kapipara/kachisys/board/forMake/kachisys_parts.pdf

Part | Value | Device | Description
C1 | 22μF | C-EUC2012 | Capacitor
C2 | 22μF | C-EUC2012 | Capacitor
C3 | UWT1E221MNL1GS | ﾆﾁｺﾝ 電解ｺﾝ 8mm | Capacitor
C4 | 0.1μF | C-EUC0603 | Capacitor
C5 | 0.1μF | C-EUC0603 | Capacitor
C6 | 100μF | C-EUC3225 | Capacitor
C7 | 1000pF | C-EUC0603 | Capacitor
C8 | 1000pF | C-EUC0603 | Capacitor
C9 | 47pF | C-EUC1608 | Capacitor
C10 | 1000pF | C-EUC0603 | Capacitor
C11 | 47pF | C-EUC1608 | Capacitor
C12 | 0.1μF | C-EUC0603 | Capacitor
C13 | 0.1μF | C-EUC0603 | Capacitor
C14 | 1000pF | C-EUC0603 | Capacitor
C15 | 1000pF | C-EUC0603 | Capacitor
C16 | 0.1μF | C-EUC0603 | Capacitor
C17 | 0.1μF | C-EUC0603 | Capacitor
C18 | 0.1μF | C-EUC0603 | Capacitor
C19 | 0.1μF | C-EUC0603 | Capacitor
C20 | 0.1μF | C-EUC0603 | Capacitor
C21 | 0.1μF | C-EUC0603 | Capacitor
IC1 | LT1963ES8-3.3 | LT1963ES8-3.3 | 3V3 Regulator
J1 | S3B-PH-SM4-TB(LF)(SN) | S3B-PH-SM4-TB(LF)(SN) | PHコネクタ 3端子
J2 | S3B-PH-SM4-TB(LF)(SN) | S3B-PH-SM4-TB(LF)(SN) | PHコネクタ 3端子
J3 | S3B-PH-SM4-TB(LF)(SN) | S3B-PH-SM4-TB(LF)(SN) | PHコネクタ 3端子
J4 | S3B-PH-SM4-TB(LF)(SN) | S3B-PH-SM4-TB(LF)(SN) | PHコネクタ 3端子
J5 | S3B-PH-SM4-TB(LF)(SN) | S3B-PH-SM4-TB(LF)(SN) | PHコネクタ 3端子
J6 | S3B-PH-SM4-TB(LF)(SN) | S3B-PH-SM4-TB(LF)(SN) | PHコネクタ 3端子
J7 | S3B-PH-SM4-TB(LF)(SN) | S3B-PH-SM4-TB(LF)(SN) | PHコネクタ 3端子
J8 | ZX62R-AB-5P | ZX62R-AB-5P | Micro USB
J9 | 2DC-0415D200 | 2DC-0415D200 | DC Jack
LED1 | WS2812B_5050N | WS2812B_5050N | RGB LED
LED2 | WS2812B_5050N | WS2812B_5050N | RGB LED
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
TPAD5 | ESP32-TOUCHPAD | ESP32-TOUCHPAD | 表面タッチパッド
TPAD6 | ESP32-TOUCHPAD | ESP32-TOUCHPAD | 表面タッチパッド
TX | LED | LEDCHIP-LED0603 | chip LED
RX | LED | LEDCHIP-LED0603 | chip LED
U1 | FT231XS | FT231XS | USB⇔UART変換チップ
U2 | ESP-WROOM-32 | ESP-WROOM-32 | ESP32
U3 | BME280 | BME280 | 温湿度センサ
