kapipara/kachisys/kachisys.old/kachisys_body.stl

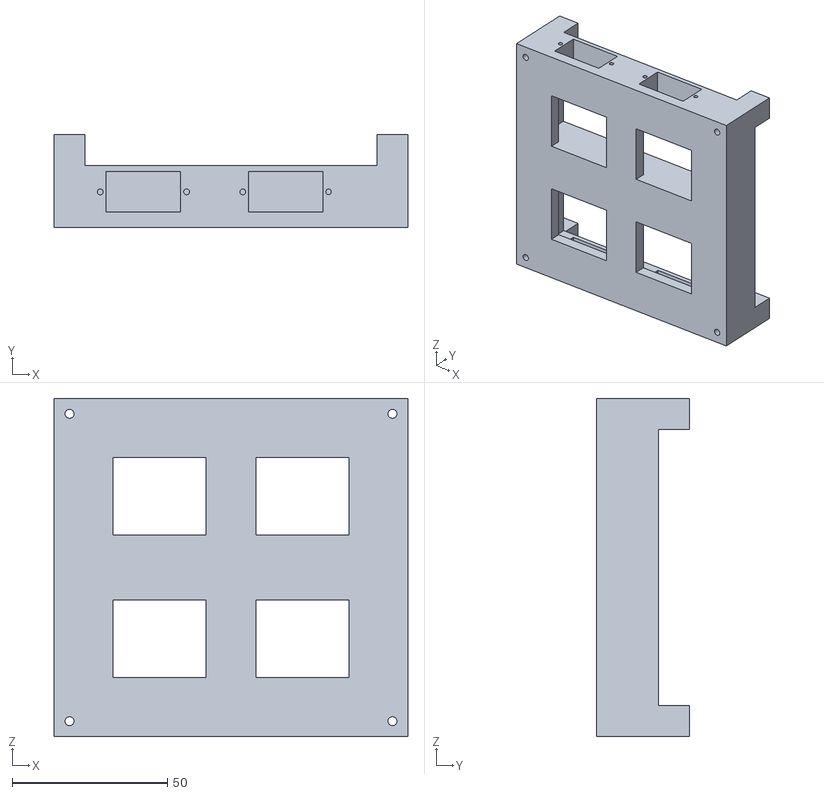
[picture p1: CAD file, 2018-10-15, an earlier design]
kachisys.old/kachisys_body.stl
114.0 x 30.0 x 109.0
