kapipara/kachisys/board/forMake/kachisys_sch.pdf

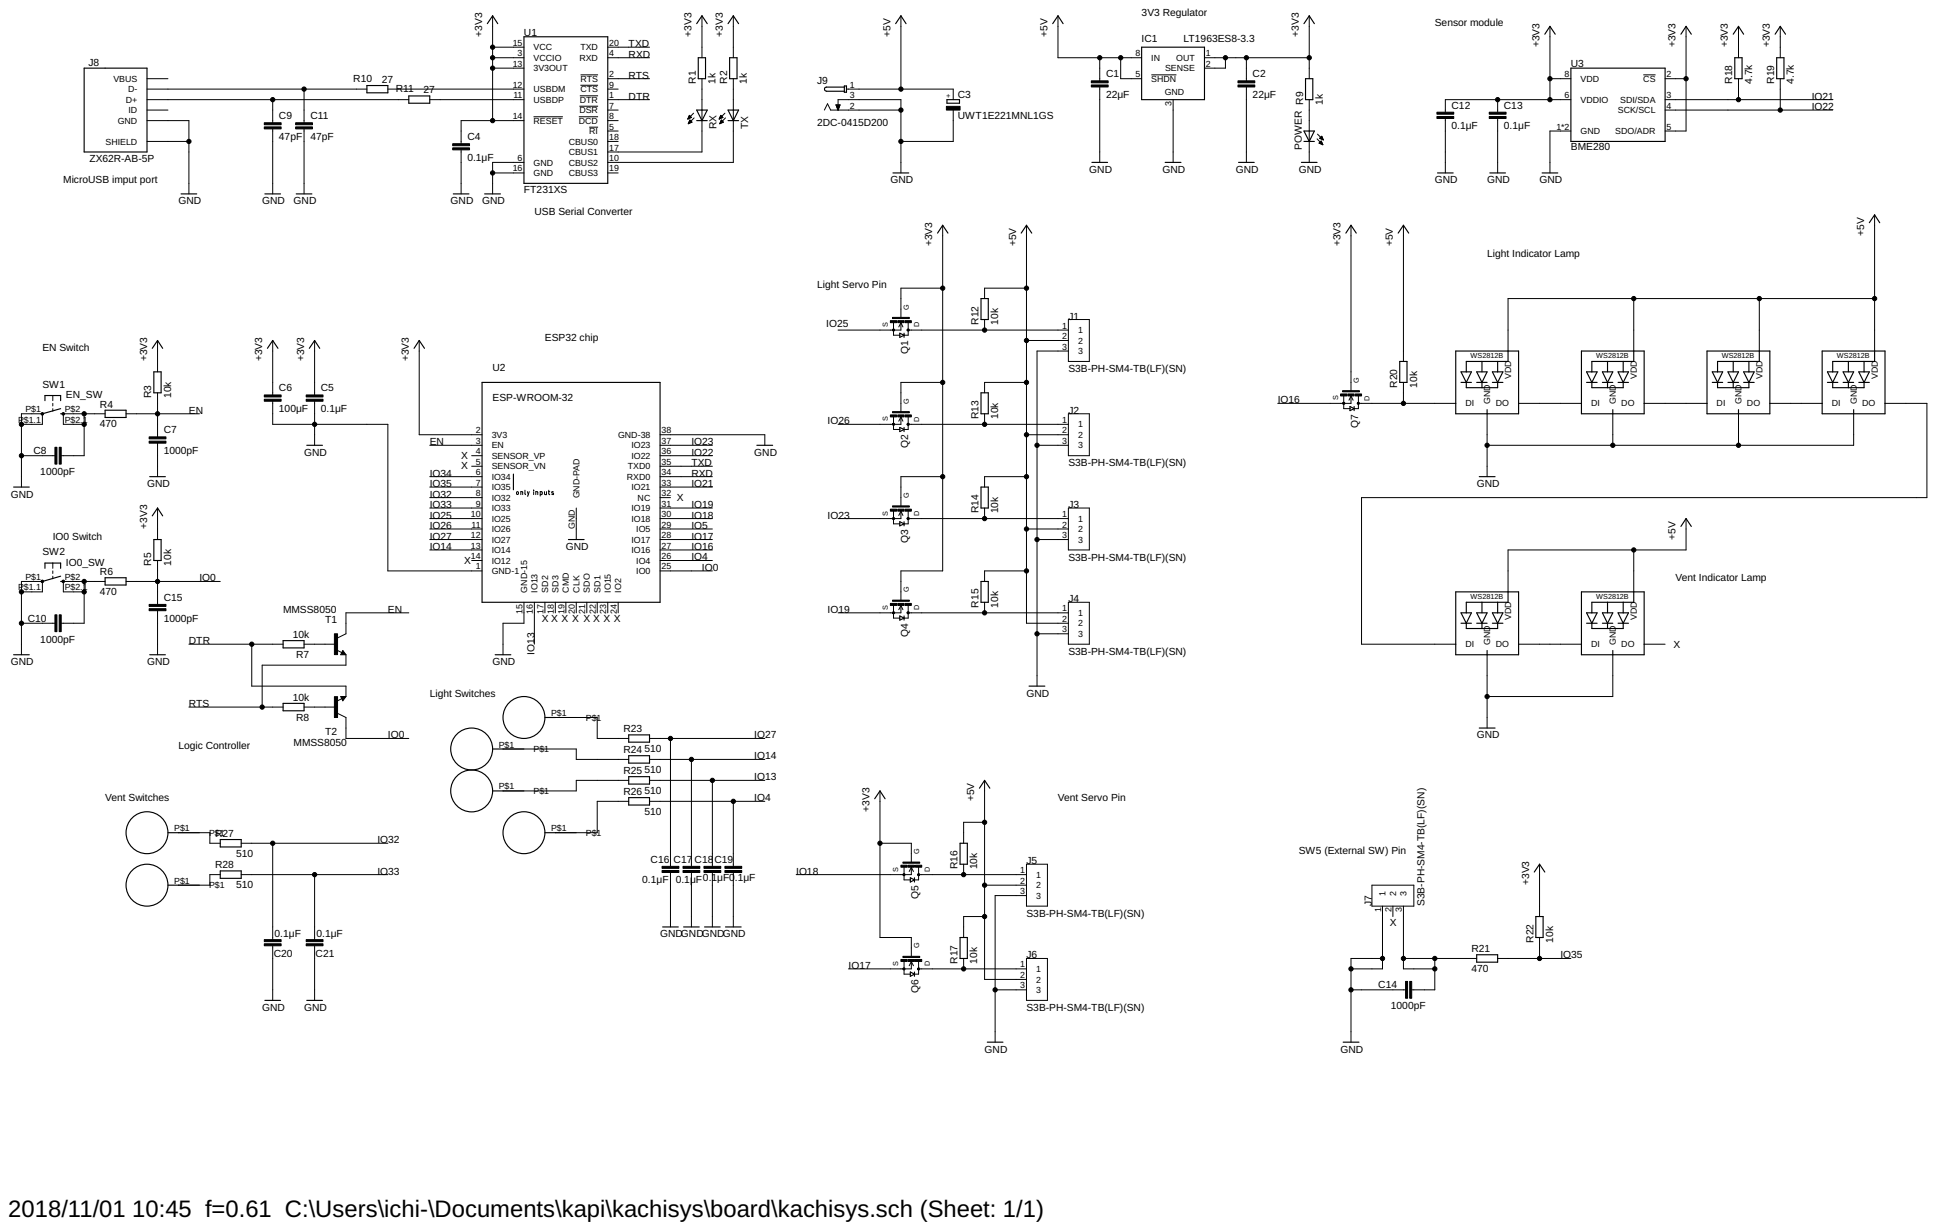
[picture p2: page 1]

USB Serial Converter MicroUSB imput port

S3B-PH-SM4-TB(LF)(SN) GND

2018/11/01 10:45 f=0.61 C:\Users\ichi-\Documents\kapi\kachisys\board\kachisys.sch (Sheet: 1/1)
