kapipara/kachisys/board/kachisys_bottom.pdf

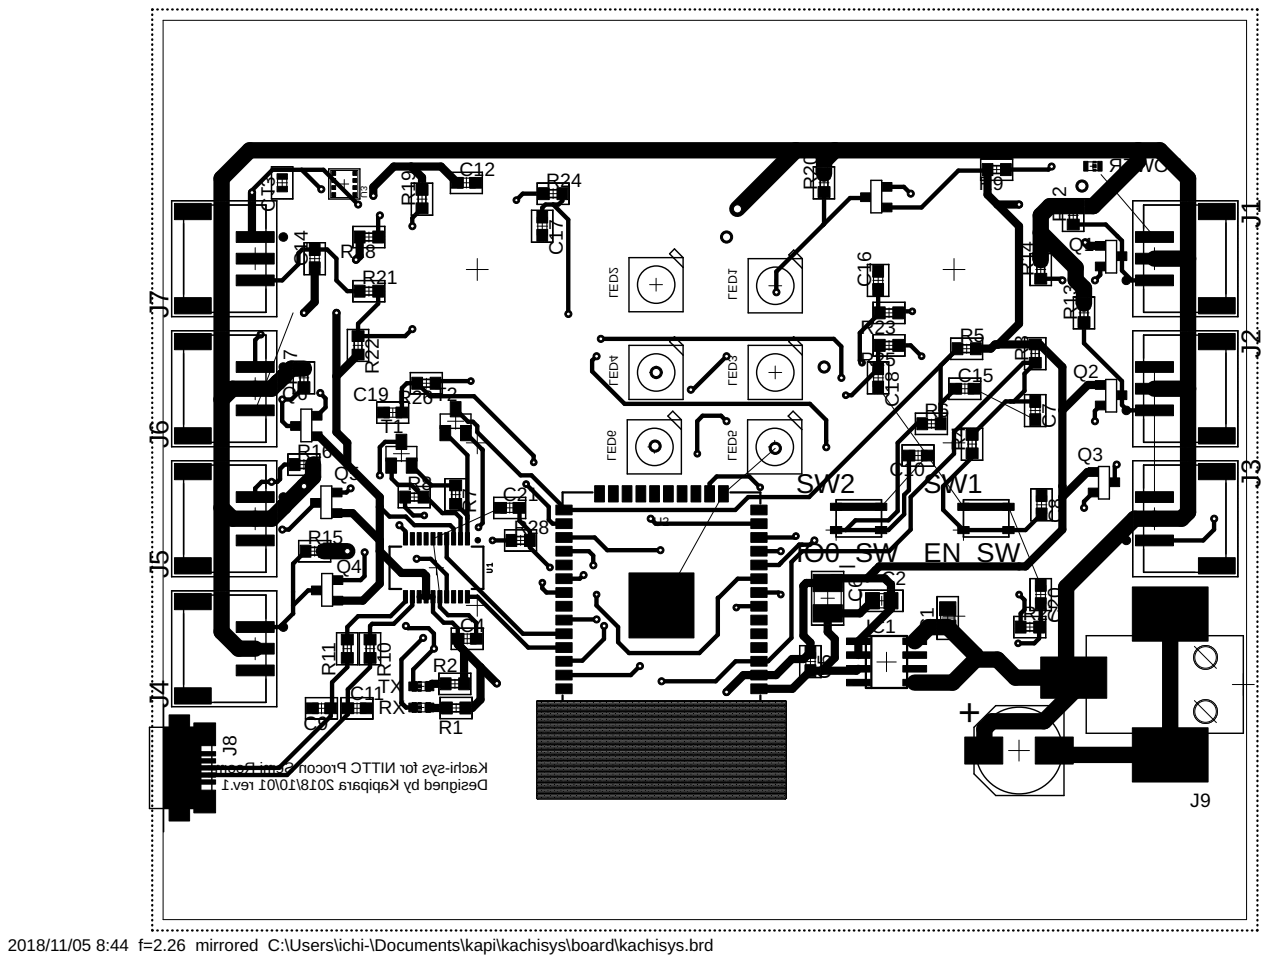
[picture p3: page 1]

2018/11/05 8:44 f=2.26 mirrored C:\Users\ichi-\Documents\kapi\kachisys\board\kachisys.brd
