kapipara/kachisys/board/kachisys_top.pdf

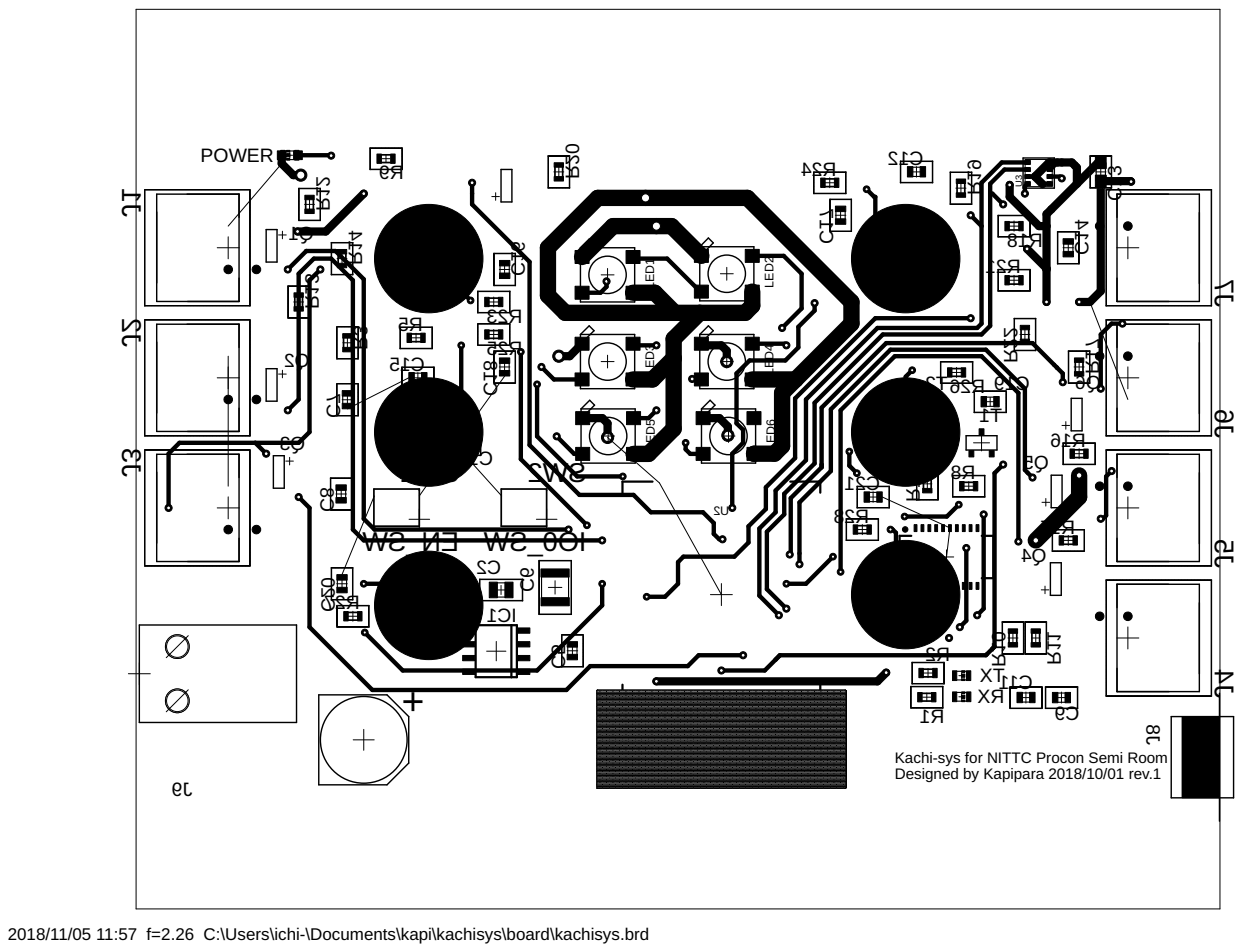
[picture p4: page 1]

Kachi-sys for NITTC Procon Semi Room
Designed by Kapipara 2018/10/01 rev.1

2018/11/05 11:57 f=2.26 C:\Users\ichi-\Documents\kapi\kachisys\board\kachisys.brd
