kapipara/kachisys/物理スイッチのとき/kachisys.brd

## EAGLE design 物理スイッチのとき/kachisys.brd (2019-01-18)

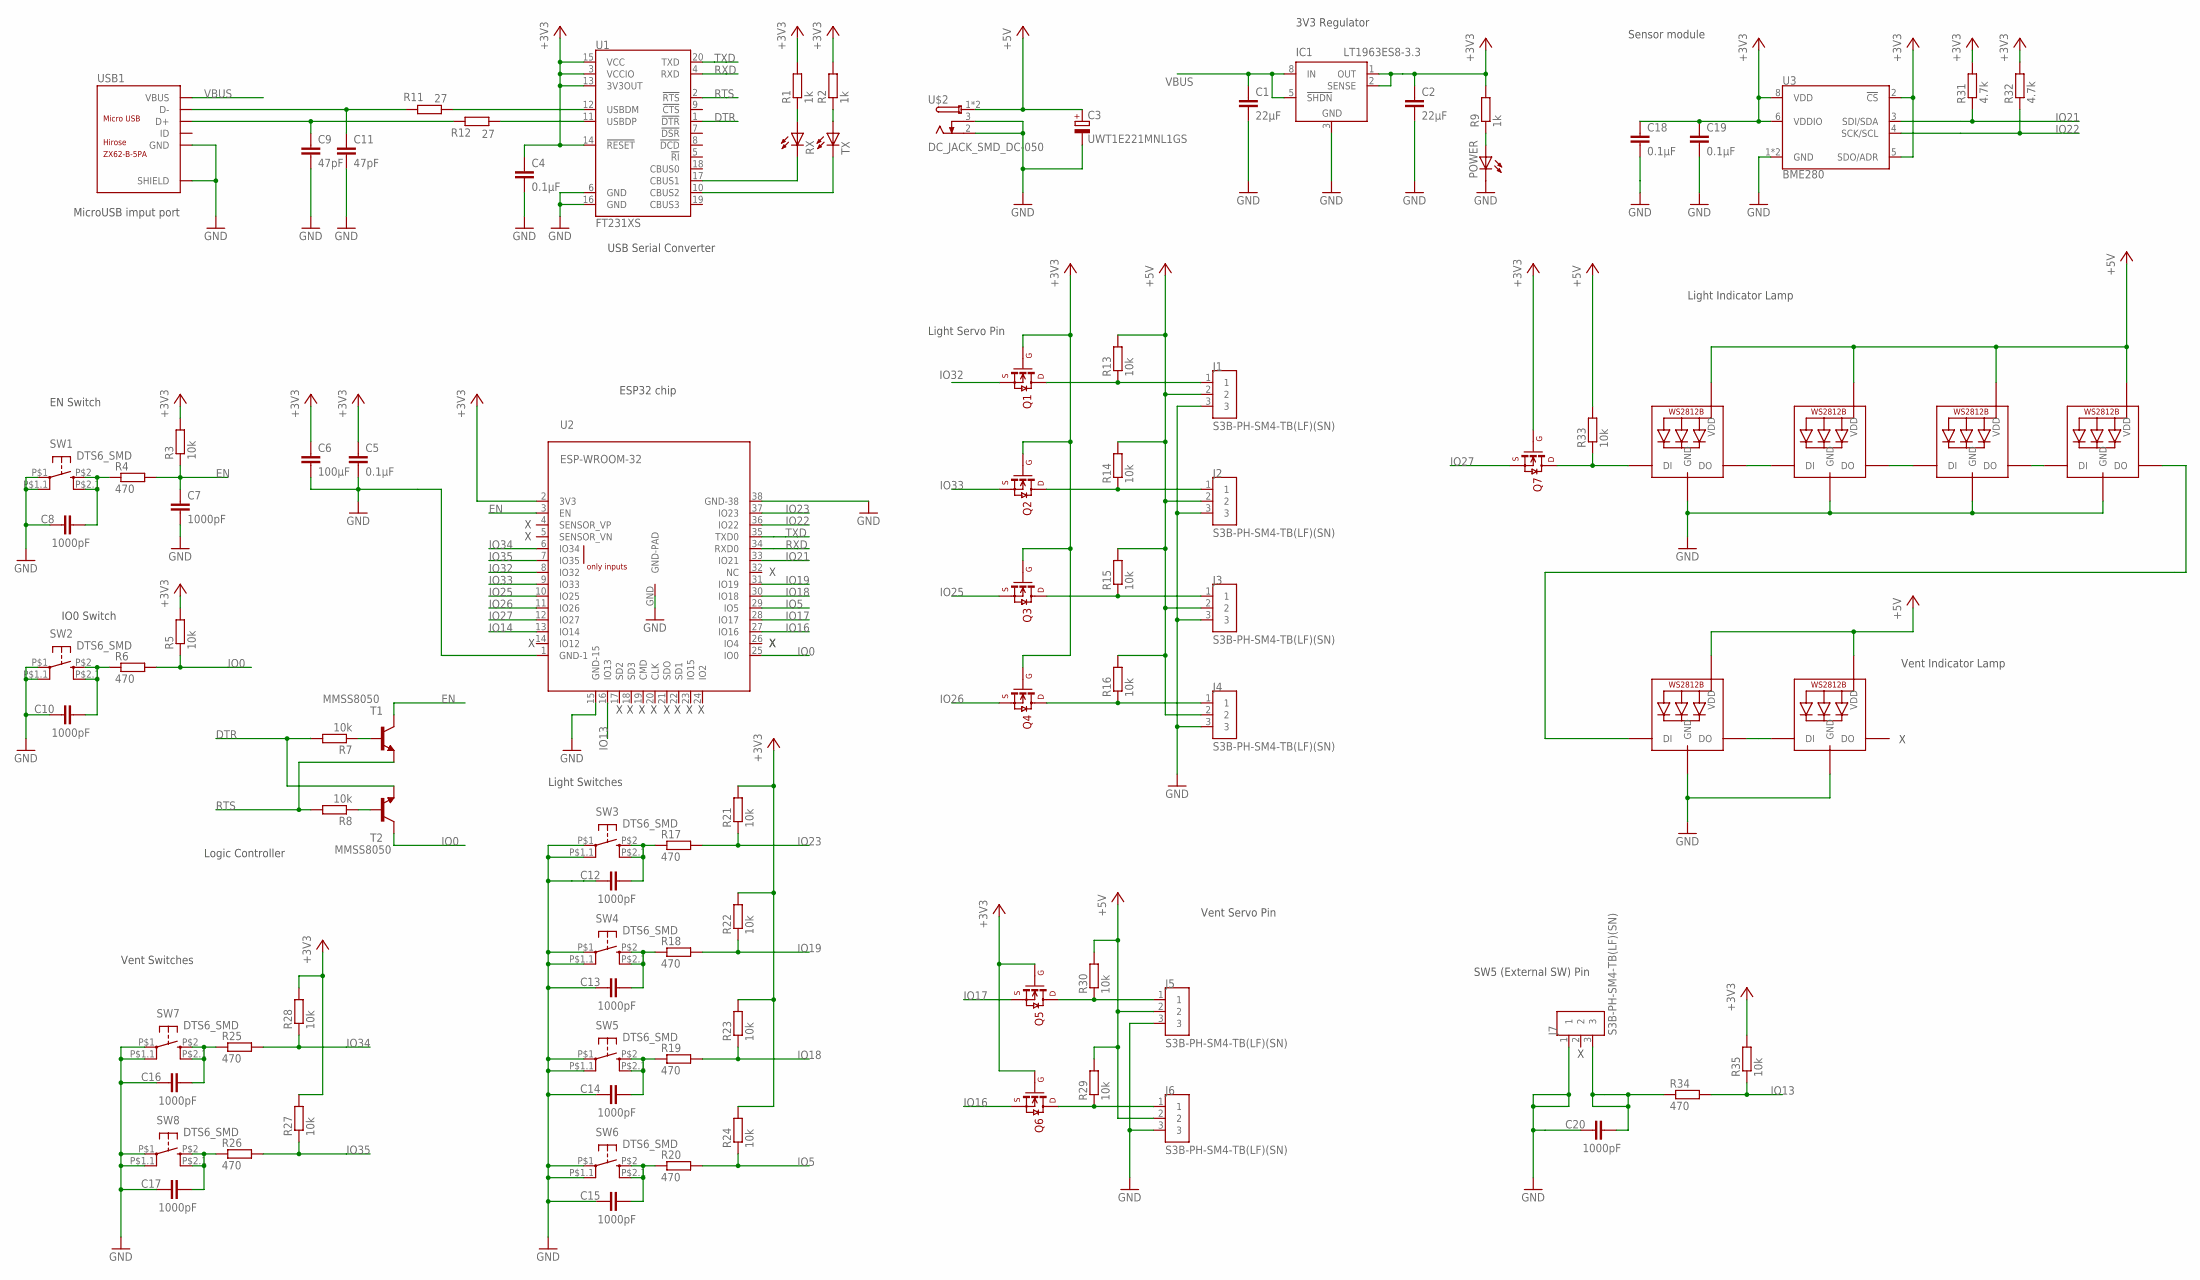
[picture p5: schematic kachisys.sch]

Parts:
C1, C2: 22μF; C2012
C3: UWT1E221MNL1GS; NICHICON-ALMINUM-CAPACITOR-8MM
C4, C5, C18, C19: 0.1μF; C0603
C6: 100μF; C3225
C7, C8, C10, C12, C13, C14, C15, C16, C17, C20: 1000pF; C0603
C9, C11: 47pF; C1608
IC1: LT1963ES8-3.3; SOIC8
J1, J2, J3, J4, J5, J6, J7: S3B-PH-SM4-TB(LF)(SN); JST_S3B-PH-SM4-TB(LF)(SN)
LED1, LED2, LED3, LED4, LED5, LED6: WS2812B_5050N; WS2812B-NARROW
POWER: LEDCHIP-LED0603; CHIP-LED0603
Q1, Q2, Q3, Q4, Q5, Q6, Q7: BSS138; SOT-23
R1, R2, R9: 1k; R0603
R3, R5, R7, R8, R13, R14, R15, R16, R21, R22, R23, R24, R27, R28, R29, R30, R33, R35: 10k; R0603
R4, R6, R17, R18, R19, R20, R25, R26, R34: 470; R0603
R11, R12: 27; R0603
R31, R32: 4.7k; R0603
RX: LEDCHIP-LED0603; CHIP-LED0603
SW1, SW2, SW3, SW4, SW5, SW6, SW7, SW8: DTS6_SMD; SKRPACE010
T1, T2: MMSS8050; SOT23-EBC
TX: LEDCHIP-LED0603; CHIP-LED0603
U1: FT231XS; SSOP20_L
U2: ESP-WROOM-32
U3: BME280; LGA-8-2.5X2.5
U$2: DC_JACK_SMD_DC-050
USB1: ZX62-B-5PA; MICRO-USB5+6P-SMD-0.65-AB

Connections:
+3V3: C2.1, C4.1, C5.1, C6.1, C18.1, C19.1, IC1.1 (OUT), IC1.2 (SENSE), Q1.G, Q2.G, Q3.G, Q4.G, Q5.G, Q6.G, Q7.G, R1.2, R2.2, R3.2, R5.2, R9.2, R21.2, R22.2, R23.2, R24.2, R27.2, R28.2, R31.2, R32.2, R35.2, U1.3 (VCCIO), U1.13 (3V3OUT), U1.14 (!RESET), U1.15 (VCC), U2.2 (3V3), U3.2 (!CS), U3.5 (SDO/ADR), U3.6 (VDDIO), U3.8 (VDD)
+5V: C3.POS (+), J1.2, J2.2, J3.2, J4.2, J5.2, J6.2, LED1.1-VDD (VDD), LED2.1-VDD (VDD), LED3.1-VDD (VDD), LED4.1-VDD (VDD), LED5.1-VDD (VDD), LED6.1-VDD (VDD), R13.2, R14.2, R15.2, R16.2, R29.2, R30.2, R33.2, U$2.1, U$2.1-1 (1)
DTR: R7.2, T2.E, U1.1 (!DTR)
EN: C7.1, R3.1, R4.2, T1.C, U2.3 (EN)
GND: C1.2, C2.2, C3.NEG (-), C4.2, C5.2, C6.2, C7.2, C8.1, C9.2, C10.1, C11.2, C12.1, C13.1, C14.1, C15.1, C16.1, C17.1, C18.2, C19.2, C20.1, IC1.3 (GND), IC1.6 (GND), IC1.7 (GND), J1.3, J2.3, J3.3, J4.3, J5.3, J6.3, J7.1, LED1.3-GND (GND), LED2.3-GND (GND), LED3.3-GND (GND), LED4.3-GND (GND), LED5.3-GND (GND), LED6.3-GND (GND), POWER.C, SW1.P$1, SW1.P$1.1 (P1), SW2.P$1, SW2.P$1.1 (P1), SW3.P$1, SW3.P$1.1 (P1), SW4.P$1, SW4.P$1.1 (P1), SW5.P$1, SW5.P$1.1 (P1), SW6.P$1, SW6.P$1.1 (P1), SW7.P$1, SW7.P$1.1 (P1), SW8.P$1, SW8.P$1.1 (P1), U1.6 (GND), U1.16 (GND), U2.1 (GND-1), U2.15 (GND-15), U2.38 (GND-38), U2.GND (GND-PAD), U3.1 (GND), U3.7 (GND), U$2.2, U$2.3, USB1.5 (GND), USB1.P1 (SHIELD), USB1.P2 (SHIELD), USB1.P3 (SHIELD), USB1.P4 (SHIELD), USB1.P5 (SHIELD), USB1.P6 (SHIELD)
IO0: R5.1, R6.2, T2.C, U2.25 (IO0)
IO5: R20.2, R24.1, U2.29 (IO5)
IO13: R34.2, R35.1, U2.16 (IO13)
IO14: U2.13 (IO14)
IO16: Q6.S, U2.27 (IO16)
IO17: Q5.S, U2.28 (IO17)
IO18: R19.2, R23.1, U2.30 (IO18)
IO19: R18.2, R22.1, U2.31 (IO19)
IO21: R31.1, U2.33 (IO21), U3.3 (SDI/SDA)
IO22: R32.1, U2.36 (IO22), U3.4 (SCK/SCL)
IO23: R17.2, R21.1, U2.37 (IO23)
IO25: Q3.S, U2.10 (IO25)
IO26: Q4.S, U2.11 (IO26)
IO27: Q7.S, U2.12 (IO27)
IO32: Q1.S, U2.8 (IO32)
IO33: Q2.S, U2.9 (IO33)
IO34: R25.2, R28.1, U2.6 (IO34)
IO35: R26.2, R27.1, U2.7 (IO35)
unnamed: C11.1, R11.2, USB1.2 (D-)
unnamed: C9.1, R12.2, USB1.3 (D+)
unnamed: RX.C, U1.17 (CBUS1)
unnamed: TX.C, U1.10 (CBUS2)
unnamed: C8.2, R4.1, SW1.P$2 (S), SW1.P$2.1 (S1)
unnamed: R1.1, RX.A
unnamed: R2.1, TX.A
unnamed: R7.1, T1.B
unnamed: R8.1, T2.B
unnamed: POWER.A, R9.1
unnamed: C10.2, R6.1, SW2.P$2 (S), SW2.P$2.1 (S1)
unnamed: R11.1, U1.12 (USBDM)
unnamed: R12.1, U1.11 (USBDP)
unnamed: J1.1, Q1.D, R13.1
unnamed: J2.1, Q2.D, R14.1
unnamed: J3.1, Q3.D, R15.1
unnamed: J4.1, Q4.D, R16.1
unnamed: C12.2, R17.1, SW3.P$2 (S), SW3.P$2.1 (S1)
unnamed: LED1.2-DOUT (DO), LED2.4-DIN (DI)
unnamed: C13.2, R18.1, SW4.P$2 (S), SW4.P$2.1 (S1)
unnamed: C14.2, R19.1, SW5.P$2 (S), SW5.P$2.1 (S1)
unnamed: C15.2, R20.1, SW6.P$2 (S), SW6.P$2.1 (S1)
unnamed: LED2.2-DOUT (DO), LED3.4-DIN (DI)
unnamed: C16.2, R25.1, SW7.P$2 (S), SW7.P$2.1 (S1)
unnamed: C17.2, R26.1, SW8.P$2 (S), SW8.P$2.1 (S1)
unnamed: LED3.2-DOUT (DO), LED4.4-DIN (DI)
unnamed: LED4.2-DOUT (DO), LED5.4-DIN (DI)
unnamed: J5.1, Q5.D, R30.1
unnamed: J6.1, Q6.D, R29.1
unnamed: LED5.2-DOUT (DO), LED6.4-DIN (DI)
unnamed: LED1.4-DIN (DI), Q7.D, R33.1
unnamed: C20.2, J7.3, R34.1
RTS: R8.2, T1.E, U1.2 (!RTS)
RXD: U1.4 (RXD), U2.34 (RXD0)
TXD: U1.20 (TXD), U2.35 (TXD0)
VBUS: C1.1, IC1.5 (!SHDN), IC1.8 (IN), USB1.1 (VBUS)

Notes on the sheet:
3V3 Regulator
USB Serial Converter
MicroUSB imput port
EN Switch
IO0 Switch
Logic Controller
ESP32 chip
Light Servo Pin
Light Switches
Vent Switches
Sensor module
Vent Servo Pin
Light Indicator Lamp
Vent Indicator Lamp
SW5 (External SW) Pin

Board: 2 copper layers, 93 parts (0 on the bottom side), 58 nets, no tracks yet.
