kapipara/kachisys/board/kachisys.brd

## EAGLE design board/kachisys.brd (2018-11-30)

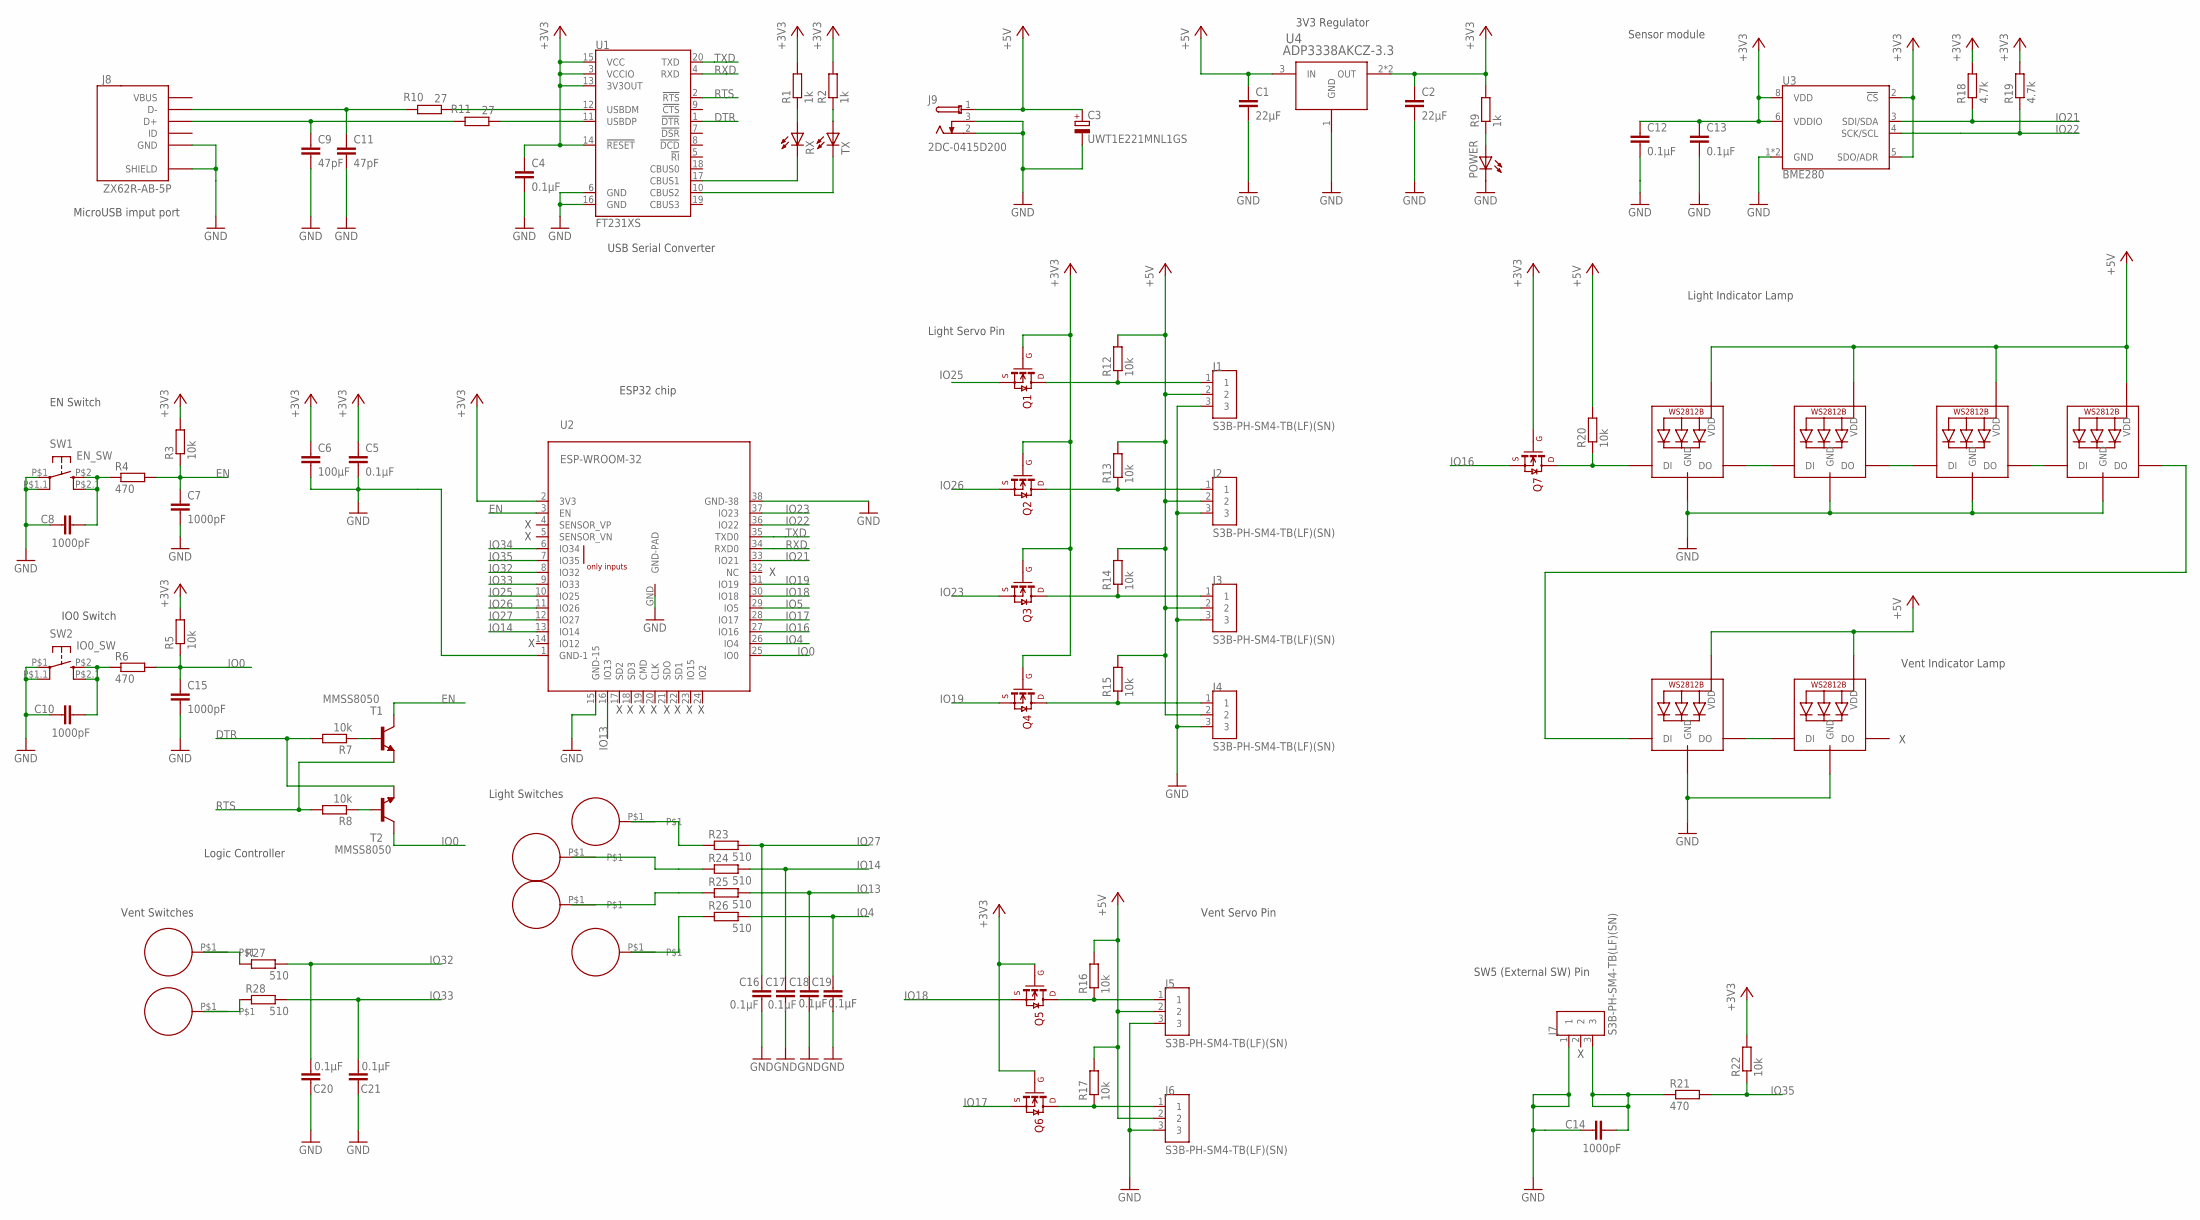
[picture p6: schematic kachisys.sch]

Parts:
C1, C2: 22μF; C2012
C3: UWT1E221MNL1GS; NICHICON-ALMINUM-CAPACITOR-8MM
C4, C5, C12, C13, C16, C17, C18, C19, C20, C21: 0.1μF; C0603
C6: 100μF; C3225
C7, C8, C10, C14, C15: 1000pF; C0603
C9, C11: 47pF; C1608
J1, J2, J3, J4, J5, J6, J7: S3B-PH-SM4-TB(LF)(SN); JST_S3B-PH-SM4-TB(LF)(SN)
J8: ZX62R-AB-5P; ZX62R-B-5PA
J9: 2DC-0415D200
LED1, LED2, LED3, LED4, LED5, LED6: WS2812B_5050N; WS2812B-NARROW
POWER: LEDCHIP-LED0603; CHIP-LED0603
Q1, Q2, Q3, Q4, Q5, Q6, Q7: BSS138; SOT-23
R1, R2, R9: 1k; R0603
R3, R5, R7, R8, R12, R13, R14, R15, R16, R17, R20, R22: 10k; R0603
R4, R6, R21: 470; R0603
R10, R11: 27; R0603
R18, R19: 4.7k; R0603
R23, R24, R25, R26, R27, R28: 510; R0603
RX: LEDCHIP-LED0603; CHIP-LED0603
SW1: EN_SW; SKRPACE010
SW2: IO0_SW; SKRPACE010
T1, T2: MMSS8050; SOT23-EBC
TPAD1, TPAD2, TPAD3, TPAD4, TPAD5, TPAD6: ESP32-TOUCHPAD; ESP32-TOUCHPAD-10MM
TX: LEDCHIP-LED0603; CHIP-LED0603
U1: FT231XS; SSOP20_L
U2: ESP-WROOM-32
U3: BME280; LGA-8-2.5X2.5
U4: ADP3338AKCZ-3.3; SOT233

Connections:
+3V3: C2.1, C4.1, C5.1, C6.1, C12.1, C13.1, Q1.G, Q2.G, Q3.G, Q4.G, Q5.G, Q6.G, Q7.G, R1.2, R2.2, R3.2, R5.2, R9.2, R18.2, R19.2, R22.2, U1.3 (VCCIO), U1.13 (3V3OUT), U1.14 (!RESET), U1.15 (VCC), U2.2 (3V3), U3.2 (!CS), U3.5 (SDO/ADR), U3.6 (VDDIO), U3.8 (VDD), U4.2 (OUT), U4.4 (OUT)
+5V: C1.1, C3.POS (+), J1.2, J2.2, J3.2, J4.2, J5.2, J6.2, J9.1, LED1.1-VDD (VDD), LED2.1-VDD (VDD), LED3.1-VDD (VDD), LED4.1-VDD (VDD), LED5.1-VDD (VDD), LED6.1-VDD (VDD), R12.2, R13.2, R14.2, R15.2, R16.2, R17.2, R20.2, U4.3 (IN)
DTR: R7.2, T2.E, U1.1 (!DTR)
EN: C7.1, R3.1, R4.2, T1.C, U2.3 (EN)
GND: C1.2, C2.2, C3.NEG (-), C4.2, C5.2, C6.2, C7.2, C8.1, C9.2, C10.1, C11.2, C12.2, C13.2, C14.1, C15.2, C16.2, C17.2, C18.2, C19.2, C20.1, C21.1, J1.3, J2.3, J3.3, J4.3, J5.3, J6.3, J7.1, J8.GND, J8.SHIELD@1 (SHIELD), J8.SHIELD@2 (SHIELD), J8.SHIELD@3 (SHIELD), J8.SHIELD@4 (SHIELD), J9.2, J9.3, LED1.3-GND (GND), LED2.3-GND (GND), LED3.3-GND (GND), LED4.3-GND (GND), LED5.3-GND (GND), LED6.3-GND (GND), POWER.C, SW1.P$1, SW1.P$1.1 (P1), SW2.P$1, SW2.P$1.1 (P1), U1.6 (GND), U1.16 (GND), U2.1 (GND-1), U2.15 (GND-15), U2.38 (GND-38), U2.GND (GND-PAD), U3.1 (GND), U3.7 (GND), U4.1 (GND)
IO0: C15.1, R5.1, R6.2, T2.C, U2.25 (IO0)
IO4: C19.1, R26.2, U2.26 (IO4)
IO5: U2.29 (IO5)
IO13: C18.1, R25.2, U2.16 (IO13)
IO14: C17.1, R24.2, U2.13 (IO14)
IO16: Q7.S, U2.27 (IO16)
IO17: Q6.S, U2.28 (IO17)
IO18: Q5.S, U2.30 (IO18)
IO19: Q4.S, U2.31 (IO19)
IO21: R18.1, U2.33 (IO21), U3.3 (SDI/SDA)
IO22: R19.1, U2.36 (IO22), U3.4 (SCK/SCL)
IO23: Q3.S, U2.37 (IO23)
IO25: Q1.S, U2.10 (IO25)
IO26: Q2.S, U2.11 (IO26)
IO27: C16.1, R23.2, U2.12 (IO27)
IO32: C20.2, R27.2, U2.8 (IO32)
IO33: C21.2, R28.2, U2.9 (IO33)
IO34: U2.6 (IO34)
IO35: R21.2, R22.1, U2.7 (IO35)
unnamed: R27.1, TPAD5.P$1
unnamed: C11.1, J8.D-, R10.2
unnamed: C9.1, J8.D+, R11.2
unnamed: RX.C, U1.17 (CBUS1)
unnamed: TX.C, U1.10 (CBUS2)
unnamed: C8.2, R4.1, SW1.P$2 (S), SW1.P$2.1 (S1)
unnamed: R1.1, RX.A
unnamed: R2.1, TX.A
unnamed: R7.1, T1.B
unnamed: R8.1, T2.B
unnamed: POWER.A, R9.1
unnamed: C10.2, R6.1, SW2.P$2 (S), SW2.P$2.1 (S1)
unnamed: R28.1, TPAD6.P$1
unnamed: R10.1, U1.12 (USBDM)
unnamed: R11.1, U1.11 (USBDP)
unnamed: J1.1, Q1.D, R12.1
unnamed: J2.1, Q2.D, R13.1
unnamed: J3.1, Q3.D, R14.1
unnamed: J4.1, Q4.D, R15.1
unnamed: LED1.2-DOUT (DO), LED2.4-DIN (DI)
unnamed: LED2.2-DOUT (DO), LED3.4-DIN (DI)
unnamed: LED3.2-DOUT (DO), LED4.4-DIN (DI)
unnamed: LED4.2-DOUT (DO), LED5.4-DIN (DI)
unnamed: J5.1, Q5.D, R16.1
unnamed: J6.1, Q6.D, R17.1
unnamed: LED5.2-DOUT (DO), LED6.4-DIN (DI)
unnamed: LED1.4-DIN (DI), Q7.D, R20.1
unnamed: C14.2, J7.3, R21.1
unnamed: R23.1, TPAD1.P$1
unnamed: R24.1, TPAD2.P$1
unnamed: R25.1, TPAD3.P$1
unnamed: R26.1, TPAD4.P$1
RTS: R8.2, T1.E, U1.2 (!RTS)
RXD: U1.4 (RXD), U2.34 (RXD0)
TXD: U1.20 (TXD), U2.35 (TXD0)

Notes on the sheet:
3V3 Regulator
USB Serial Converter
MicroUSB imput port
EN Switch
IO0 Switch
Logic Controller
ESP32 chip
Light Servo Pin
Light Switches
Vent Switches
Sensor module
Vent Servo Pin
Light Indicator Lamp
Vent Indicator Lamp
SW5 (External SW) Pin

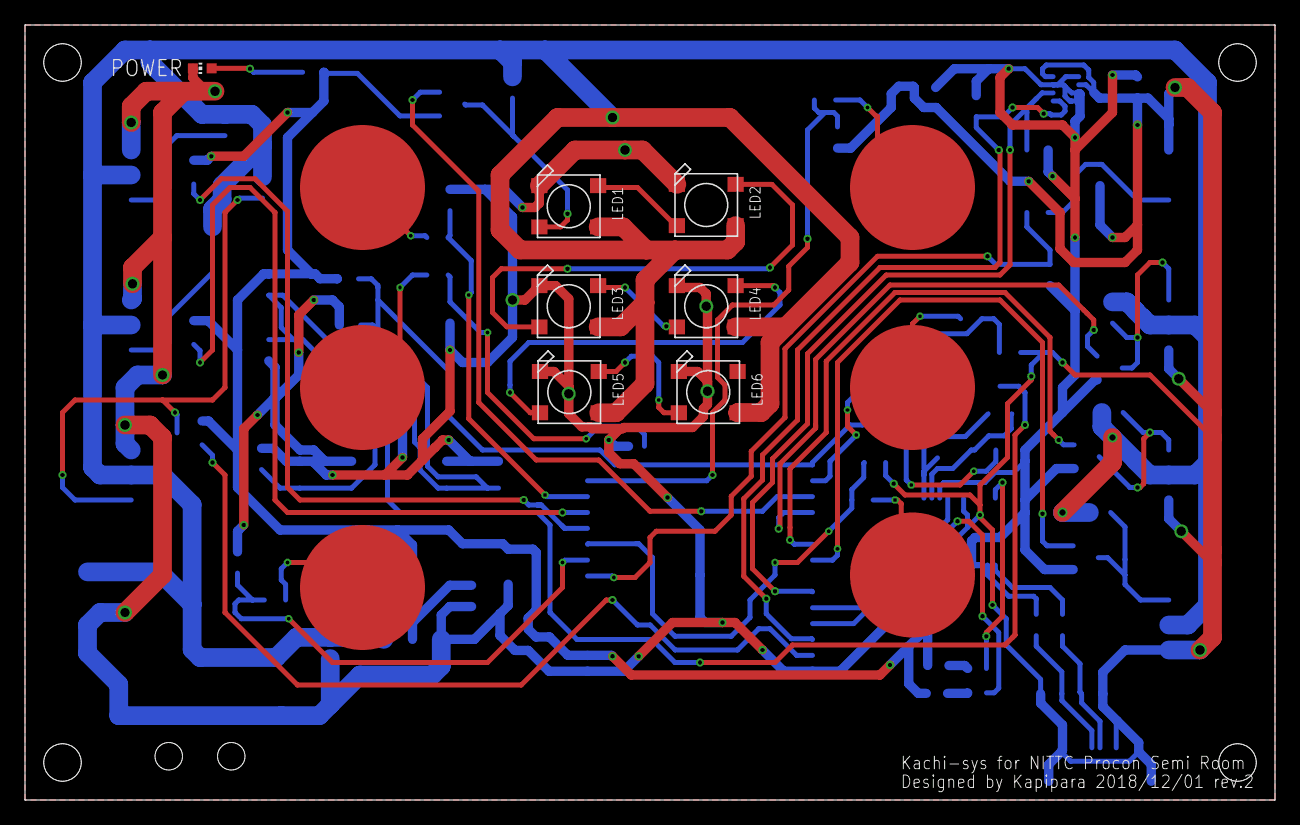
[picture p7: board board/kachisys.brd from above]

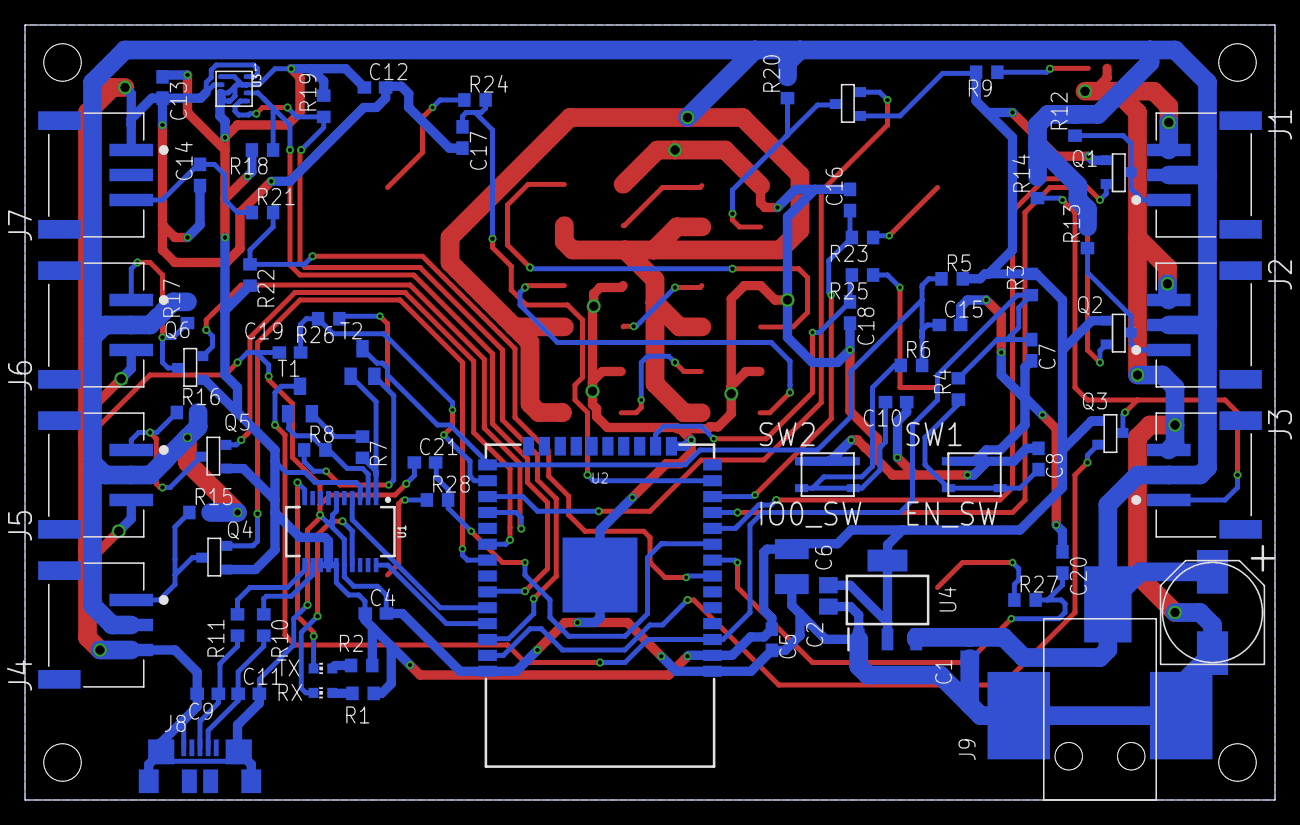
[picture p8: board board/kachisys.brd from below]

Board: 2 copper layers, 100.0 x 62.0 mm, 88 parts (75 on the bottom side), 57 nets.
