kapipara/kachisys/kachisys.old/board/kachisys_board.brd

## EAGLE design kachisys.old/board/kachisys_board.brd (2018-10-15, an earlier design)

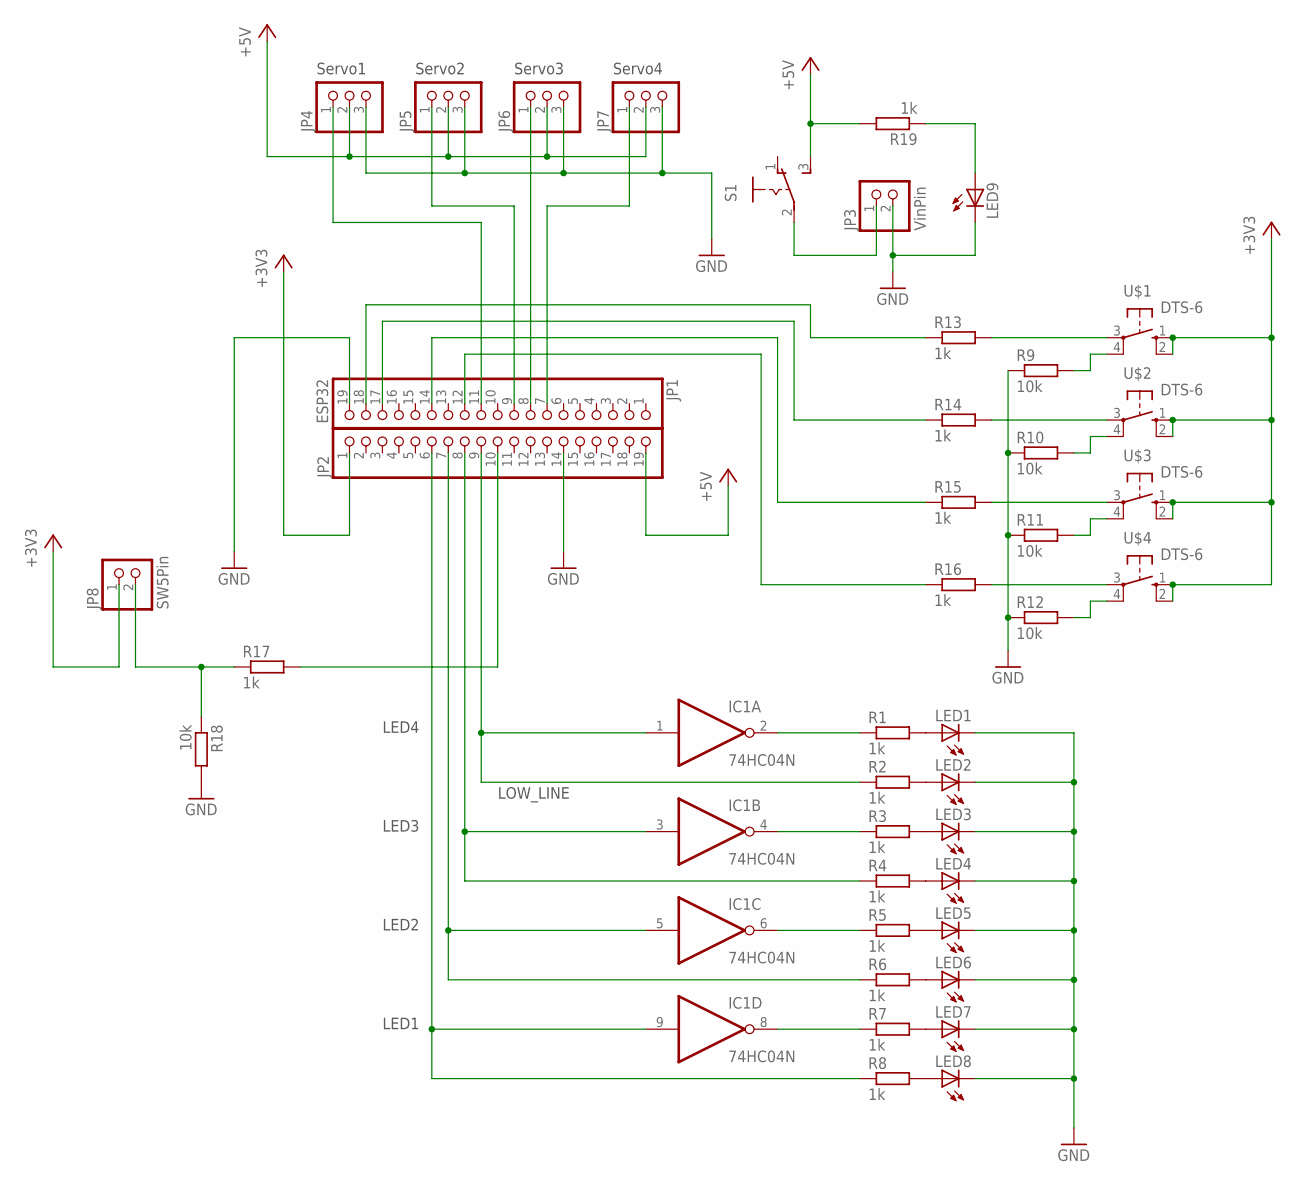
[picture p9: schematic kachisys_board.sch]

Parts:
IC1: 74HC04N; DIL14
JP1: ESP32; 1X19
JP2: 1X19
JP3: VinPin; 1X02/90
JP4, JP5, JP6, JP7: PINHD-1X3; 1X03
JP8: SW5Pin; 1X02/90
LED1, LED2, LED3, LED4, LED5, LED6, LED7, LED8, LED9: LED3MM
R1, R2, R3, R4, R5, R6, R7, R8, R13, R14, R15, R16, R17, R19: 1k; M2012
R9, R10, R11, R12, R18: 10k; M2012
S1: 255SB
U$1, U$2, U$3, U$4: DTS-6; DTS6

Connections:
+3V3: JP2.1, JP8.1, U$1.1 (S), U$1.2 (S1), U$2.1 (S), U$2.2 (S1), U$3.1 (S), U$3.2 (S1), U$4.1 (S), U$4.2 (S1)
+5V: JP2.19, JP4.2, JP5.2, JP6.2, JP7.2, R19.2, S1.3 (S)
GND: IC1.7 (GND), JP1.19, JP2.14, JP3.2, JP4.3, JP5.3, JP6.3, JP7.3, LED1.K (C), LED2.K (C), LED3.K (C), LED4.K (C), LED5.K (C), LED6.K (C), LED7.K (C), LED8.K (C), LED9.K (C), R9.1, R10.1, R11.1, R12.1, R18.2
unnamed: IC1.9 (I), JP2.6, R8.1
unnamed: IC1.5 (I), JP2.7, R6.1
unnamed: IC1.3 (I), JP2.8, R4.1
unnamed: IC1.1 (I), JP2.9, R2.1
unnamed: IC1.2 (O), R1.1
unnamed: IC1.4 (O), R3.1
unnamed: IC1.6 (O), R5.1
unnamed: IC1.8 (O), R7.1
unnamed: LED1.A, R1.2
unnamed: LED2.A, R2.2
unnamed: LED3.A, R3.2
unnamed: LED4.A, R4.2
unnamed: LED5.A, R5.2
unnamed: LED6.A, R6.2
unnamed: LED7.A, R7.2
unnamed: LED8.A, R8.2
unnamed: R9.2, U$1.4 (P1)
unnamed: R10.2, U$2.4 (P1)
unnamed: R11.2, U$3.4 (P1)
unnamed: R12.2, U$4.4 (P1)
unnamed: JP8.2, R17.1, R18.1
unnamed: R13.2, U$1.3
unnamed: R14.2, U$2.3
unnamed: R15.2, U$3.3
unnamed: JP1.7, JP7.1
unnamed: JP1.8, JP6.1
unnamed: JP1.9, JP5.1
unnamed: JP1.11, JP4.1
unnamed: R16.2, U$4.3
unnamed: JP1.12, R16.1
unnamed: JP1.14, R15.1
unnamed: JP1.17, R14.1
unnamed: JP1.18, R13.1
unnamed: JP3.1, S1.2
unnamed: LED9.A, R19.1
unnamed: JP2.10, R17.2
VCC: IC1.14 (VCC)

Notes on the sheet:
LOW_LINE
LED1
LED2
LED3
LED4
Servo1
Servo2
Servo3
Servo4

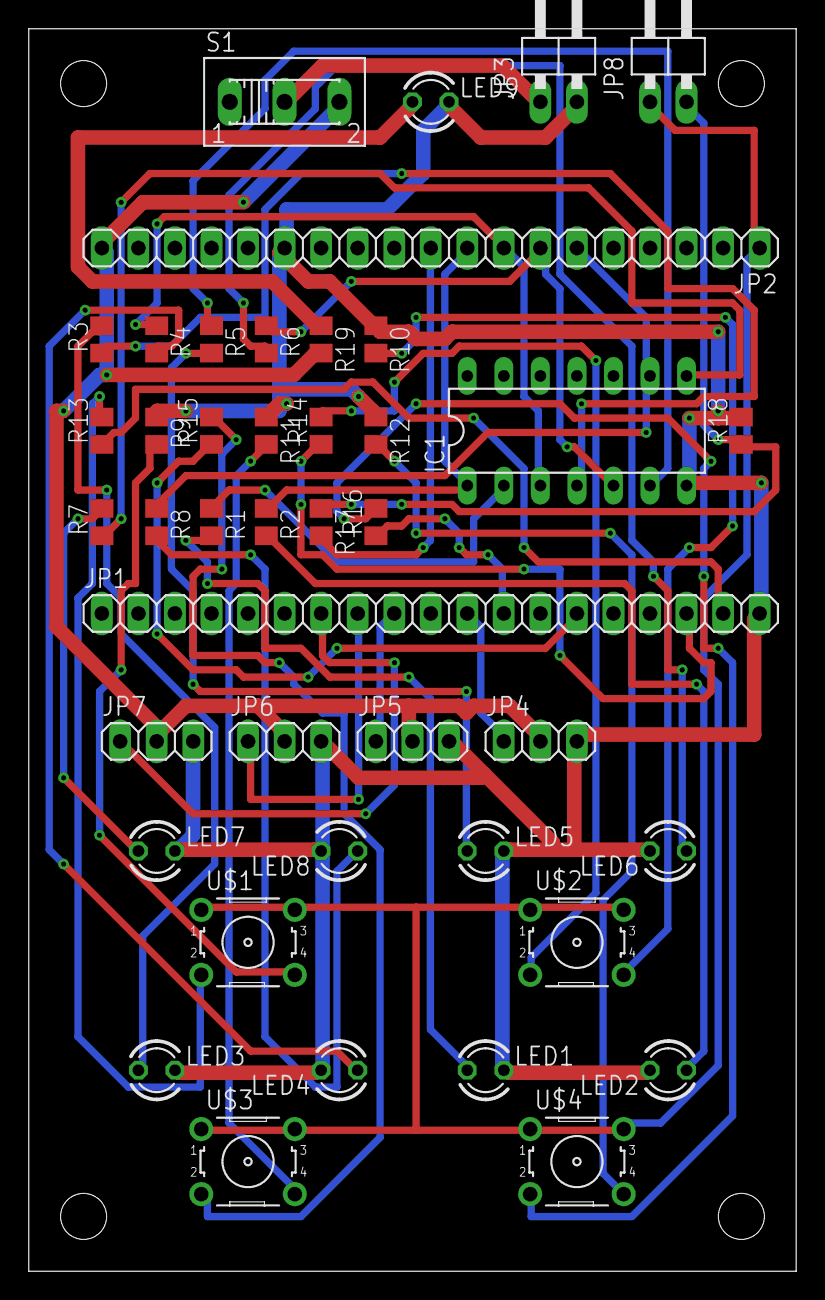
[picture p10: board kachisys_board.brd from above]

Board: 2 copper layers, 53.3 x 86.4 mm, 42 parts (0 on the bottom side), 39 nets.
