kapipara/kachisys/kachisys.old/esp32/board/kachisysBoard.brd

## EAGLE design kachisys.old/esp32/board/kachisysBoard.brd (2018-10-15, an earlier design)

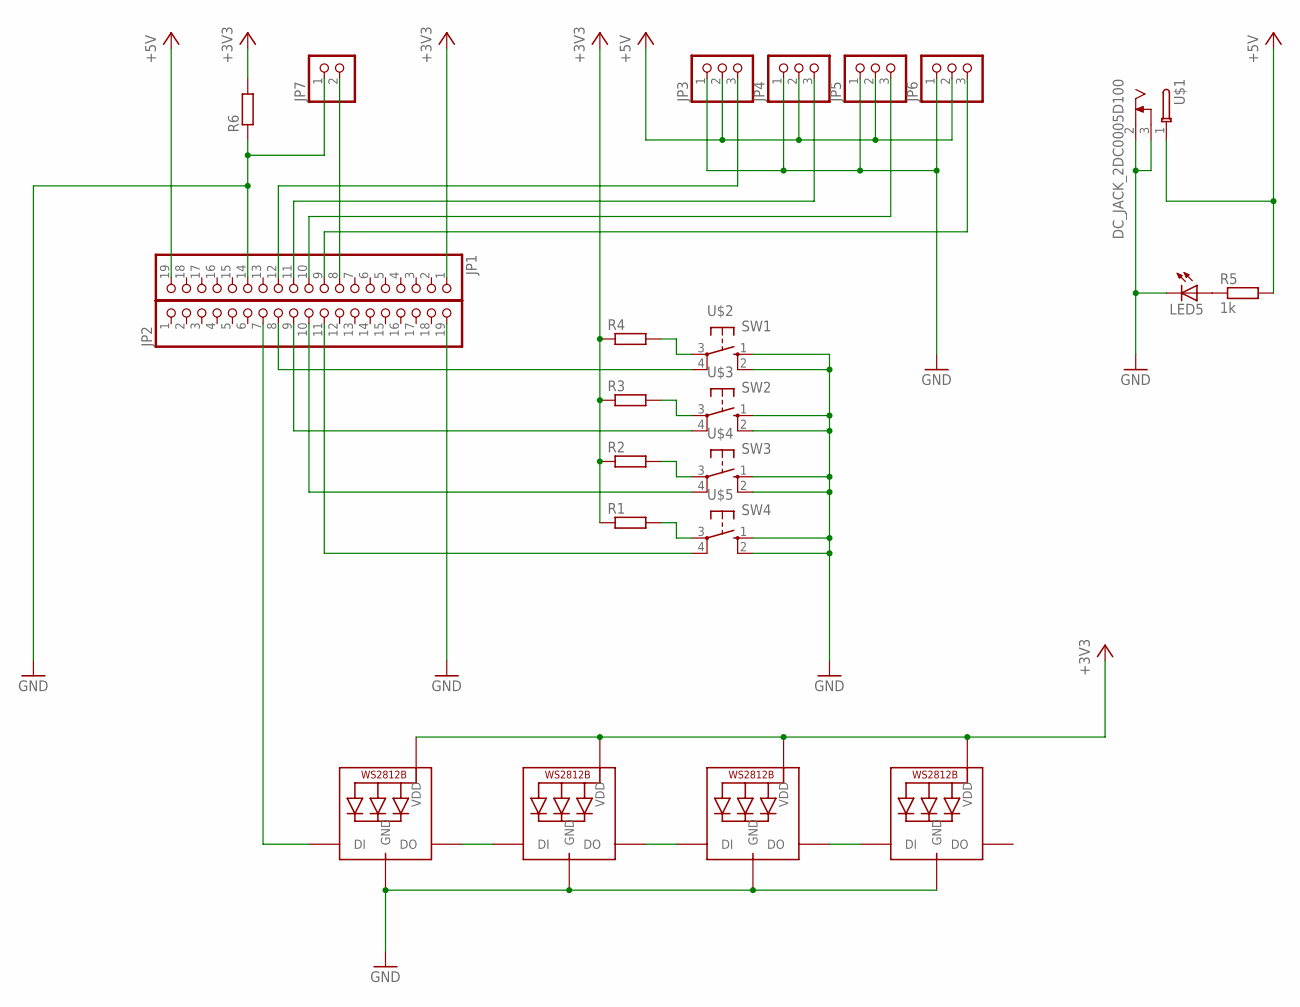
[picture p11: schematic kachisysBoard.sch]

Parts:
JP1, JP2: PINHD-1X19; 1X19
JP3, JP4, JP5, JP6: PINHD-1X3/90; 1X03/90
JP7: PINHD-1X2/90; 1X02/90
LED1, LED2, LED3, LED4: WS2812B5050; WS2812B
LED5: LED3MM
R1, R2, R3, R4, R6: R-EU_M3216; M3216
R5: 1k; M3216
U$1: DC_JACK_2DC0005D100
U$2: SW1; DTS6
U$3: SW2; DTS6
U$4: SW3; DTS6
U$5: SW4; DTS6

Connections:
+3V3: JP1.1, LED1.1-VDD (VDD), LED2.1-VDD (VDD), LED3.1-VDD (VDD), LED4.1-VDD (VDD), R1.1, R2.1, R3.1, R4.1, R6.2
+5V: JP1.19, JP3.2, JP4.2, JP5.2, JP6.2, R5.2, U$1.1
GND: JP1.14, JP2.19, JP3.1, JP4.1, JP5.1, JP6.1, JP7.1, LED1.3-GND (GND), LED2.3-GND (GND), LED3.3-GND (GND), LED4.3-GND (GND), LED5.K (C), R6.1, U$1.2, U$1.3, U$2.1 (S), U$2.2 (S1), U$3.1 (S), U$3.2 (S1), U$4.1 (S), U$4.2 (S1), U$5.1 (S), U$5.2 (S1)
unnamed: R1.2, U$5.3
unnamed: LED1.2-DOUT (DO), LED2.4-DIN (DI)
unnamed: LED2.2-DOUT (DO), LED3.4-DIN (DI)
unnamed: LED3.2-DOUT (DO), LED4.4-DIN (DI)
unnamed: R2.2, U$4.3
unnamed: R3.2, U$3.3
unnamed: R4.2, U$2.3
unnamed: JP2.7, LED1.4-DIN (DI)
unnamed: JP2.8, U$2.4 (P1)
unnamed: JP2.9, U$3.4 (P1)
unnamed: JP2.10, U$4.4 (P1)
unnamed: JP2.11, U$5.4 (P1)
unnamed: LED5.A, R5.1
unnamed: JP1.11, JP4.3
unnamed: JP1.10, JP5.3
unnamed: JP1.9, JP6.3
unnamed: JP1.8, JP7.2

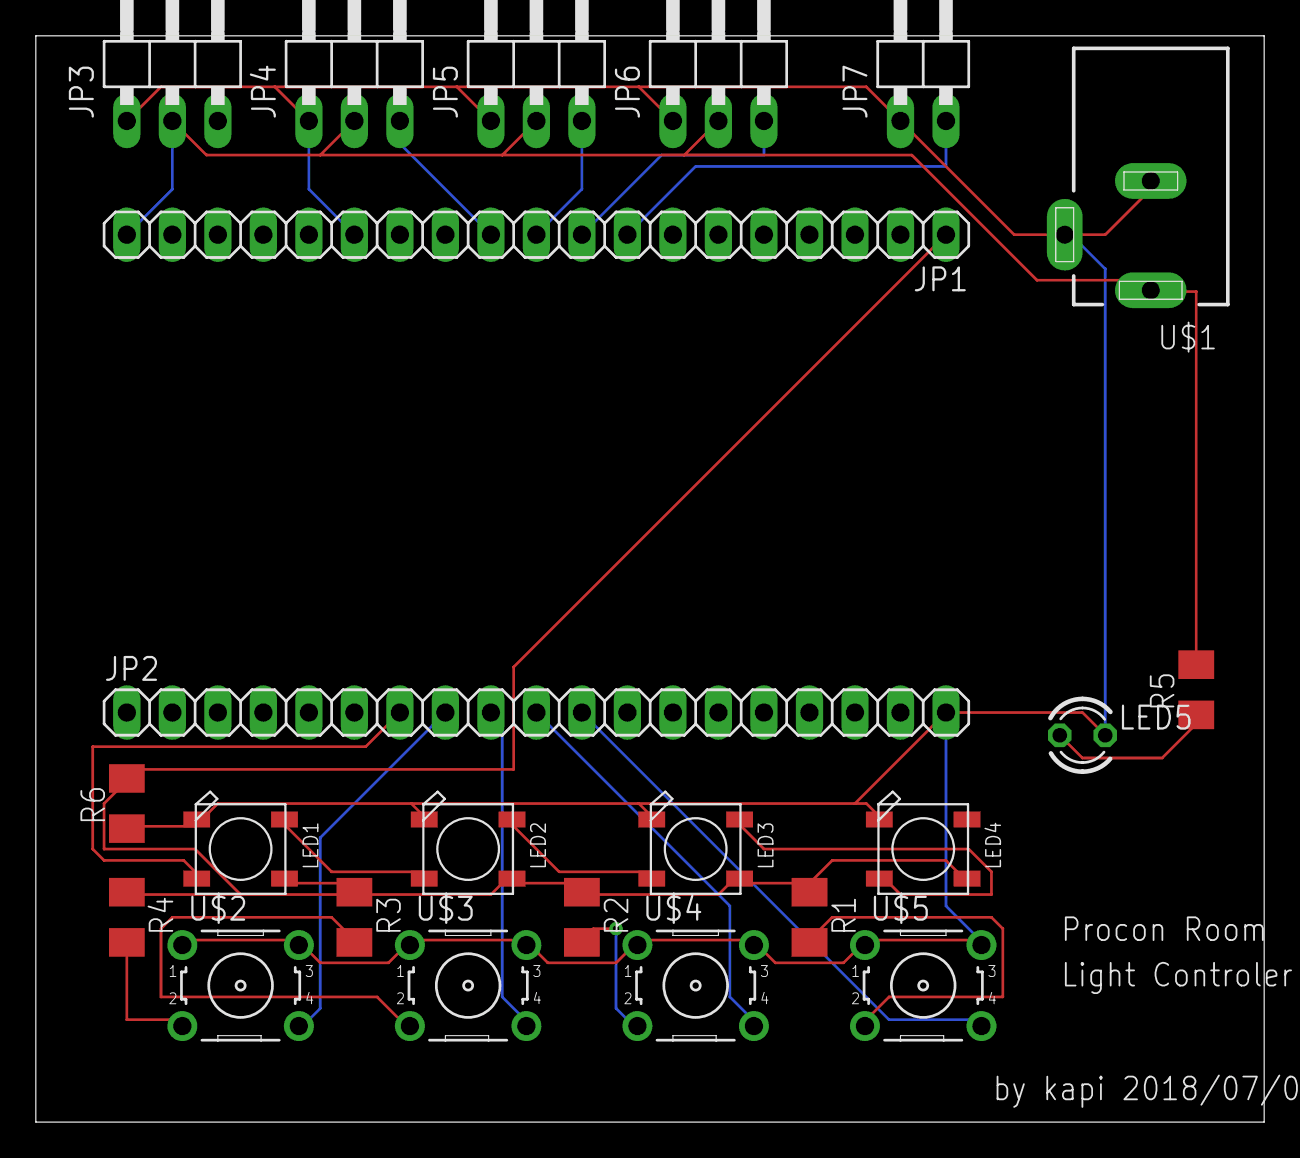
[picture p12: board kachisysBoard.brd from above]

Board: 2 copper layers, 68.6 x 60.6 mm, 23 parts (0 on the bottom side), 20 nets.
