kapipara/kachisys/(commit log)

2018-10-02 board data upload
    [kachisys.GBL, kachisys.GBO, kachisys.GBP, kachisys.GBS, kachisys.GTL, kachisys.GTO, kachisys.GTP, kachisys.GTS]
2018-10-15 旧kachisysの遺産ファイルをアップロード
    [kachisysBoard.brd, kachisysBoard.sch, kachisys_board.brd, kachisys_board.sch, kachisys_body.stl]
2018-11-30 rev.2 upload
    [kachisys.GBL, kachisys.GBO, kachisys.GBP, kachisys.GBS, kachisys.GTL, kachisys.GTO, kachisys.GTP, kachisys.GTS]
2018-11-30 garv修正，謎のAirwire修正
    [kachisys.brd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]
2018-11-30 rev.2完成
    [kachisys.brd, kachisys.sch]
