kapipara/kachisys/(notices)

Notices in the files:
parts and their libraries:
SparkFun-IC-Comms: Licensing: Creative Commons ShareAlike 4.0 International - https://creativecommons.org/licenses/by-sa/4.0
